ky0nq/VGA_security_homecam/UVM/OV7670_VGA/scenario2/rtl/MEM_CONTROLLER.sv

`timescale 1ns / 1ps

module MEM_CONTROLLER #(
    parameter int H_ACT      = 320,
    parameter int V_ACT      = 240,
    parameter int DATA_WIDTH = 16,
    parameter int ADDR_WIDTH = $clog2(H_ACT * V_ACT)
)(
    input  logic                    pclk,
    input  logic                    reset,
    input  logic                    href,
    input  logic                    v_sync,
    input  logic [7:0]              pdata,

    output logic                    we,
    output logic [ADDR_WIDTH-1:0]   addr,
    output logic [DATA_WIDTH-1:0]   data
);

    localparam int MAX_PIXELS = H_ACT * V_ACT;

    logic                    byte_sel;   
    logic [7:0]              hi_byte;   
    logic [ADDR_WIDTH-1:0]   pix_cnt;   

    always_ff @(posedge pclk or posedge reset) begin
        if (reset) begin
            byte_sel <= 1'b0;
            hi_byte  <= 8'd0;
            pix_cnt  <= '0;
            we       <= 1'b0;
            addr     <= '0;
            data     <= 16'd0;
        end else begin
            we <= 1'b0; 

            if (v_sync) begin
                byte_sel <= 1'b0;
                pix_cnt  <= '0;
            end else if (href) begin
                if (!byte_sel) begin
                    hi_byte  <= pdata;
                    byte_sel <= 1'b1;
                end else begin
                    byte_sel <= 1'b0;
                    if (pix_cnt < MAX_PIXELS) begin
                        we      <= 1'b1;
                        addr    <= pix_cnt;
                        data    <= {hi_byte, pdata};
                        pix_cnt <= pix_cnt + 1'b1;
                    end
                end
            end else begin
                byte_sel <= 1'b0;
            end
        end
    end
endmodule
