ky0nq/VGA_security_homecam/Board_2/gaussian_filter.sv

`timescale 1ns / 1ps

// =================================================================================
// Module: gauss_filter_pipe (Box Blur implementation)
// Description: Implements WIN x WIN spatial moving average filter (Box Blur).
// Architecture: 2-Stage Pipelined Summation
//   - Stage 1: Computes row-wise partial sums (WIN pixels per row)
//   - Stage 2: Combines row sums into a total sum and normalizes by WIN^2
// Latency: (WIN - 1) * IMG_WIDTH + WIN + 4 pclk cycles
// =================================================================================

module gauss_filter_pipe #(
    parameter int IMG_WIDTH = 800,  // Pixels per line (H_Whole_line)
    parameter int WIN       = 16   // Filter window size (WIN x WIN)
)(
    input  logic        clk,
    input  logic        rst_n,

    input  logic        i_h_sync,
    input  logic        i_v_sync,
    input  logic [11:0] i_rgb,      // {R[3:0], G[3:0], B[3:0]}

    output logic        o_h_sync,
    output logic        o_v_sync,
    output logic [11:0] o_rgb
);

    localparam int WEIGHT_SUM = WIN * WIN;
    localparam int LATENCY    = (WIN - 1) * IMG_WIDTH + WIN + 4;

    // Local Pixel Clock Generation
    logic pclk;
    pclk_gen U_PCLK_GEN (
        .clk   (clk),
        .rst_n (rst_n),
        .pclk  (pclk)
    );

    // Stage 0: Input Registering
    logic [11:0] rgb_in_r;
    always_ff @(posedge clk or negedge rst_n) begin
        if (!rst_n) rgb_in_r <= '0;
        else if (pclk) rgb_in_r <= i_rgb;
    end

    // Line Buffer Arrays (Row Streaming)
    logic [11:0] row_stream [0:WIN-1];
    assign row_stream[0] = rgb_in_r;

    genvar r;
    generate
        for (r = 1; r < WIN; r = r + 1) begin : gen_linebuf
            logic [11:0] line_buf [0:IMG_WIDTH-1];
            always_ff @(posedge clk or negedge rst_n) begin
                if (!rst_n) begin
                    for (int k = 0; k < IMG_WIDTH; k = k + 1) line_buf[k] <= '0;
                end else if (pclk) begin
                    for (int k = IMG_WIDTH-1; k > 0; k = k - 1)
                        line_buf[k] <= line_buf[k-1];
                    line_buf[0] <= row_stream[r-1];
                end
            end
            assign row_stream[r] = line_buf[IMG_WIDTH-1];
        end
    endgenerate

    // Column Shift Registers (Spatial Window Tap)
    logic [11:0] col_tap [0:WIN-1][0:WIN-1];

    genvar rr;
    generate
        for (rr = 0; rr < WIN; rr = rr + 1) begin : gen_colshift
            always_ff @(posedge clk or negedge rst_n) begin
                if (!rst_n) begin
                    for (int c = 0; c < WIN; c = c + 1) col_tap[rr][c] <= '0;
                end else if (pclk) begin
                    for (int c = WIN-1; c > 0; c = c - 1)
                        col_tap[rr][c] <= col_tap[rr][c-1];
                    col_tap[rr][0] <= row_stream[rr];
                end
            end
        end
    endgenerate

    // Stage 1: Row Partial Summation
    logic [15:0] row_sum_r_c [0:WIN-1];
    logic [15:0] row_sum_g_c [0:WIN-1];
    logic [15:0] row_sum_b_c [0:WIN-1];
    logic [15:0] row_sum_r   [0:WIN-1];
    logic [15:0] row_sum_g   [0:WIN-1];
    logic [15:0] row_sum_b   [0:WIN-1];

    genvar rs;
    generate
        for (rs = 0; rs < WIN; rs = rs + 1) begin : gen_row_sum
            always_comb begin
                row_sum_r_c[rs] = '0;
                row_sum_g_c[rs] = '0;
                row_sum_b_c[rs] = '0;
                for (int c = 0; c < WIN; c = c + 1) begin
                    row_sum_r_c[rs] = row_sum_r_c[rs] + col_tap[rs][c][11:8];
                    row_sum_g_c[rs] = row_sum_g_c[rs] + col_tap[rs][c][7:4];
                    row_sum_b_c[rs] = row_sum_b_c[rs] + col_tap[rs][c][3:0];
                end
            end
            always_ff @(posedge clk or negedge rst_n) begin
                if (!rst_n) begin
                    row_sum_r[rs] <= '0;
                    row_sum_g[rs] <= '0;
                    row_sum_b[rs] <= '0;
                end else if (pclk) begin
                    row_sum_r[rs] <= row_sum_r_c[rs];
                    row_sum_g[rs] <= row_sum_g_c[rs];
                    row_sum_b[rs] <= row_sum_b_c[rs];
                end
            end
        end
    endgenerate

    // Stage 2: Total Summation
    logic [23:0] sum_r_c, sum_g_c, sum_b_c;
    logic [23:0] sum_r,   sum_g,   sum_b;

    always_comb begin
        sum_r_c = '0; sum_g_c = '0; sum_b_c = '0;
        for (int rs2 = 0; rs2 < WIN; rs2 = rs2 + 1) begin
            sum_r_c = sum_r_c + row_sum_r[rs2];
            sum_g_c = sum_g_c + row_sum_g[rs2];
            sum_b_c = sum_b_c + row_sum_b[rs2];
        end
    end

    always_ff @(posedge clk or negedge rst_n) begin
        if (!rst_n) begin
            sum_r <= '0; sum_g <= '0; sum_b <= '0;
        end else if (pclk) begin
            sum_r <= sum_r_c;
            sum_g <= sum_g_c;
            sum_b <= sum_b_c;
        end
    end

    // Normalization & Output Stage
    function automatic logic [3:0] normalize(input logic [23:0] sum);
        logic [23:0] avg;
        avg = sum / WEIGHT_SUM;
        normalize = (avg > 24'd15) ? 4'hF : avg[3:0];
    endfunction

    logic [3:0] blur_r, blur_g, blur_b;
    assign blur_r = normalize(sum_r);
    assign blur_g = normalize(sum_g);
    assign blur_b = normalize(sum_b);

    always_ff @(posedge clk or negedge rst_n) begin
        if (!rst_n) begin
            o_rgb <= '0;
        end else if (pclk) begin
            o_rgb <= {blur_r, blur_g, blur_b};
        end
    end

    // Sync Signal Delay Pipeline (Matching Data Latency)
    logic [LATENCY-1:0] h_sync_d, v_sync_d;

    always_ff @(posedge clk or negedge rst_n) begin
        if (!rst_n) begin
            h_sync_d <= {LATENCY{1'b1}};
            v_sync_d <= {LATENCY{1'b1}};
        end else if (pclk) begin
            h_sync_d <= {h_sync_d[LATENCY-2:0], i_h_sync};
            v_sync_d <= {v_sync_d[LATENCY-2:0], i_v_sync};
        end
    end

    assign o_h_sync = h_sync_d[LATENCY-1];
    assign o_v_sync = v_sync_d[LATENCY-1];

endmodule
