ky0nq/VGA_security_homecam/UVM/Top/AUTH_LOCKOUT/TB/components/uvm_agent.sv

// Per-board agent containing the sequencer, driver, and monitor.
class Agent extends uvm_agent;
    `uvm_component_utils(Agent)
    Sequencer sqr;
    Driver    drv;
    Monitor   mon;
    function new(string name = "Agent", uvm_component parent = null);
        super.new(name, parent);
    endfunction
    function void build_phase(uvm_phase phase);
        super.build_phase(phase);
        sqr = Sequencer::type_id::create("sqr", this);
        drv = Driver::type_id::create("drv", this);
        mon = Monitor::type_id::create("mon", this);
    endfunction
    function void connect_phase(uvm_phase phase);
        super.connect_phase(phase);
        drv.seq_item_port.connect(sqr.seq_item_export);
    endfunction
endclass
