ky0nq/VGA_security_homecam/UVM/Top/AUTH_LOCKOUT/TB/components/uvm_sequencer.sv

// Pass sequence transactions to the driver.
class Sequencer extends uvm_sequencer #(transaction);
    `uvm_component_utils(Sequencer)
    function new(string name = "Sequencer", uvm_component parent = null);
        super.new(name, parent);
    endfunction
endclass
