ky0nq/VGA_security_homecam/UVM/OV7670_VGA/scenario2/tb/vga/vga_pkg.sv

`ifndef VGA_PKG_SV
`define VGA_PKG_SV
//======================================================================
//  vga_pkg
//======================================================================
package vga_pkg;
  `include "uvm_macros.svh"
  import uvm_pkg::*;
  `include "defs.svh"

  `include "vga_frame_txn.sv"
  `include "vga_monitor.sv"
  `include "vga_agent.sv"
endpackage
`endif
