ky0nq/VGA_security_homecam/UVM/OV7670_VGA/scenario2/tb/vga/vga_frame_txn.sv

`ifndef VGA_FRAME_TXN_SV
`define VGA_FRAME_TXN_SV
//======================================================================
//  vga_frame_txn : represents one observed VGA frame (active region)
//======================================================================
class vga_frame_txn extends uvm_sequence_item;
  int       HD = `VGA_HACT;
  int       VD = `VGA_VACT;
  bit [3:0] r [];
  bit [3:0] g [];
  bit [3:0] b [];
  bit       seen [];

  `uvm_object_utils(vga_frame_txn)

  function new(string name="vga_frame_txn");
    super.new(name);
    r    = new[HD*VD];
    g    = new[HD*VD];
    b    = new[HD*VD];
    seen = new[HD*VD];
  endfunction
endclass
`endif
