ky0nq/VGA_security_homecam/UVM/OV7670_VGA/scenario2/tb/sccb/sccb_txn.sv

`ifndef SCCB_TXN_SV
`define SCCB_TXN_SV
//======================================================================
//  sccb_txn : represents one 3-byte SCCB write transaction
//======================================================================
class sccb_txn extends uvm_sequence_item;
  bit [7:0] id;      // 0x42
  bit [7:0] addr;    // Register address
  bit [7:0] data;    // Register value

  `uvm_object_utils(sccb_txn)

  function new(string name="sccb_txn");
    super.new(name);
  endfunction

  function string convert2string();
    return $sformatf("SCCB id=%02h addr=%02h data=%02h", id, addr, data);
  endfunction
endclass
`endif
