ky0nq/VGA_security_homecam/UVM/OV7670_VGA/scenario2/tb/sccb/sccb_pkg.sv

`ifndef SCCB_PKG_SV
`define SCCB_PKG_SV
//======================================================================
//  sccb_pkg 
//======================================================================
package sccb_pkg;
  `include "uvm_macros.svh"
  import uvm_pkg::*;

  `include "sccb_txn.sv"
  `include "sccb_monitor.sv"
  `include "sccb_agent.sv"
endpackage
`endif
