ky0nq/VGA_security_homecam/UVM/OV7670_VGA/scenario2/tb/cam/cam_pkg.sv

`ifndef CAM_PKG_SV
`define CAM_PKG_SV
//======================================================================
//  cam_pkg
//======================================================================
package cam_pkg;
  `include "uvm_macros.svh"
  import uvm_pkg::*;
  `include "defs.svh"

  `include "cam_cfg.sv"
  `include "cam_frame_item.sv"
  `include "cam_sequencer.sv"
  `include "cam_driver.sv"
  `include "cam_monitor.sv"
  `include "cam_agent.sv"
  `include "cam_seq_lib.sv"
endpackage
`endif
