ky0nq/VGA_security_homecam/UVM/OV7670_VGA/scenario2/tb/cam/cam_sequencer.sv

`ifndef CAM_SEQUENCER_SV
`define CAM_SEQUENCER_SV
//======================================================================
//  cam_sequencer
//======================================================================
typedef uvm_sequencer #(cam_frame_item) cam_sequencer;
`endif
