ky0nq/VGA_security_homecam/UVM/OV7670_VGA/scenario1/tb/cam_vga_agent.sv

class cam_vga_agent extends uvm_agent;
    `uvm_component_utils(cam_vga_agent)
    uvm_sequencer #(cam_vga_seq_item) sqr;
    cam_vga_driver drv;
    cam_vga_monitor mon;
    function new(string name,uvm_component parent); super.new(name,parent); endfunction
    function void build_phase(uvm_phase phase);
        super.build_phase(phase);
        sqr=uvm_sequencer#(cam_vga_seq_item)::type_id::create("sqr",this);
        drv=cam_vga_driver::type_id::create("drv",this);
        mon=cam_vga_monitor::type_id::create("mon",this);
    endfunction
    function void connect_phase(uvm_phase phase);
        drv.seq_item_port.connect(sqr.seq_item_export);
    endfunction
endclass
