ky0nq/VGA_security_homecam/Board_2/gamma_filter.sv

`timescale 1ns / 1ps

// =================================================================================
// Module: gamma_filter_pipe
// Description: Pipelined Gamma Correction filter using a 16-entry Look-Up Table (LUT).
//
// Formula: out = 15 * (in / 15)^gamma  (RGB444, 4-bit per color channel)
// Modes:
//   - gamma_level = 0: Bright    (gamma = 0.7, LUT_G07)
//   - gamma_level = 1: Brighter  (gamma = 0.3, LUT_G03)
// Latency: 1 Clock Cycle
// =================================================================================

module gamma_filter_pipe (
    input  logic        clk,
    input  logic        rst_n,

    input  logic        gamma_en,
    input  logic        gamma_level,  // 0 = Bright (G0.7), 1 = Brighter (G0.3)

    input  logic        i_h_sync,
    input  logic        i_v_sync,
    input  logic [11:0] i_rgb,

    output logic        o_h_sync,
    output logic        o_v_sync,
    output logic [11:0] o_rgb
);

    // 16-Entry Gamma Lookup Tables
    localparam logic [3:0] LUT_G03[0:15] = '{
        4'd0, 4'd7, 4'd8, 4'd9, 4'd10, 4'd11, 4'd11, 4'd12,
        4'd12, 4'd13, 4'd13, 4'd14, 4'd14, 4'd14, 4'd15, 4'd15
    };

    localparam logic [3:0] LUT_G07[0:15] = '{
        4'd0, 4'd2, 4'd4, 4'd5, 4'd6, 4'd7, 4'd8, 4'd9,
        4'd10, 4'd10, 4'd11, 4'd12, 4'd13, 4'd14, 4'd14, 4'd15
    };

    // Internal RGB Channel Signals
    logic [3:0] r_in, g_in, b_in;
    logic [3:0] r_gamma, g_gamma, b_gamma;

    // Channel De-muxing
    assign r_in = i_rgb[11:8];
    assign g_in = i_rgb[7:4];
    assign b_in = i_rgb[3:0];

    // Gamma LUT Mapping (Combinational)
    always_comb begin
        if (gamma_level) begin
            r_gamma = LUT_G03[r_in];
            g_gamma = LUT_G03[g_in];
            b_gamma = LUT_G03[b_in];
        end else begin
            r_gamma = LUT_G07[r_in];
            g_gamma = LUT_G07[g_in];
            b_gamma = LUT_G07[b_in];
        end
    end

    // Pipeline Stage 1: RGB Processing Output
    always_ff @(posedge clk or negedge rst_n) begin
        if (!rst_n) begin
            o_rgb <= 12'd0;
        end else begin
            o_rgb <= gamma_en ? {r_gamma, g_gamma, b_gamma} : i_rgb;
        end
    end

    // Pipeline Stage 1: Sync Signals Delay Matching
    always_ff @(posedge clk or negedge rst_n) begin
        if (!rst_n) begin
            o_h_sync <= 1'b1;
            o_v_sync <= 1'b1;
        end else begin
            o_h_sync <= i_h_sync;
            o_v_sync <= i_v_sync;
        end
    end

endmodule
