ky0nq/VGA_security_homecam/Board_2/blue_filter.sv

`timescale 1ns / 1ps

// =================================================================================
// Module: blue_filter_pipe
// Description: Applies a blue color filter (cool tone effect) to RGB444 video.
// Latency: 2 clock cycles
// =================================================================================

module blue_filter_pipe (
    input  logic        clk,
    input  logic        rst_n,
    input  logic        blue_en,
    input  logic        i_h_sync,
    input  logic        i_v_sync,
    input  logic [11:0] i_rgb,

    output logic        o_h_sync,
    output logic        o_v_sync,
    output logic [11:0] o_rgb
);
    localparam LATENCY = 2;

    // Stage 1: Calculate luminance weights
    logic [11:0] s1_r, s1_g, s1_b, s1_rgb;

    always_ff @(posedge clk or negedge rst_n) begin
        if (!rst_n) begin
            s1_r   <= 0;
            s1_g   <= 0;
            s1_b   <= 0;
            s1_rgb <= 0;
        end else begin
            s1_r   <= 8'd77  * i_rgb[11:8];  // R weight (~0.3)
            s1_g   <= 8'd150 * i_rgb[7:4];   // G weight (~0.58)
            s1_b   <= 8'd29  * i_rgb[3:0];   // B weight (~0.11)
            s1_rgb <= i_rgb;
        end
    end

    // Stage 2: Convert to grayscale and apply blue tint
    logic [11:0] y_sum;
    logic [ 3:0] gray;
    logic [ 3:0] blue_r, blue_g, blue_b;

    assign y_sum = s1_r + s1_g + s1_b;
    assign gray  = y_sum[11:8];

    assign blue_r = gray >> 2;             // 25% Red
    assign blue_g = gray - (gray >> 1);    // 50% Green
    assign blue_b = gray;                  // 100% Blue

    always_ff @(posedge clk or negedge rst_n) begin
        if (!rst_n) begin
            o_rgb <= 0;
        end else begin
            o_rgb <= blue_en ? {blue_r, blue_g, blue_b} : s1_rgb;
        end
    end

    // Sync signal delay matching (2 cycles)
    logic [LATENCY-1:0] h_sync_d, v_sync_d;

    always_ff @(posedge clk or negedge rst_n) begin
        if (!rst_n) begin
            h_sync_d <= {LATENCY{1'b1}};
            v_sync_d <= {LATENCY{1'b1}};
        end else begin
            h_sync_d <= {h_sync_d[LATENCY-2:0], i_h_sync};
            v_sync_d <= {v_sync_d[LATENCY-2:0], i_v_sync};
        end
    end

    assign o_h_sync = h_sync_d[LATENCY-1];
    assign o_v_sync = v_sync_d[LATENCY-1];

endmodule
