ky0nq/VGA_security_homecam/UVM/OV7670_VGA/scenario1/tb/cam_vga_test.sv

class cam_vga_sccb_reset_sequence extends uvm_sequence #(cam_vga_seq_item);
    `uvm_object_utils(cam_vga_sccb_reset_sequence)
    bit target_setup=0;
    int target_state=-1, target_step=-1;
    bit target_observed=0;
    function new(string name="sccb_reset_sequence"); super.new(name); endfunction
    task body();
        cam_vga_seq_item req;
        req=cam_vga_seq_item::type_id::create("reset_request");
        start_item(req);
        req.command=CMD_SCCB_RESET_AT;
        req.sccb_target_setup=target_setup;
        req.sccb_target_state=target_state;
        req.sccb_target_step=target_step;
        finish_item(req);
        target_observed=req.sccb_target_observed;
    endtask
endclass

class cam_vga_test extends uvm_test;
    `uvm_component_utils(cam_vga_test)
    cam_vga_env env;
    virtual cam_vga_if vif;
    string mode="camera_random";
    int num_frames=10;
    bit run_completed=0;
    function new(string name,uvm_component parent); super.new(name,parent); endfunction
    function void build_phase(uvm_phase phase);
        super.build_phase(phase);
        if(!uvm_config_db#(virtual cam_vga_if)::get(this,"","vif",vif))
            `uvm_fatal("VIF","cam_vga_test needs vif")
        void'($value$plusargs("NUM_FRAMES=%d",num_frames));
        if(num_frames<1) `uvm_fatal("NUM_FRAMES","NUM_FRAMES must be positive")
        env=cam_vga_env::type_id::create("env",this);
    endfunction
    task command(command_e cmd);
        cam_vga_command_sequence seq;
        seq=cam_vga_command_sequence::type_id::create("command_seq");
        seq.command=cmd; seq.start(env.agt.sqr);
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
