ky0nq/VGA_security_homecam/(commit log)

2026-09-01 Create board1_system
2026-09-01 Create uart_tx
2026-09-01 Add minimal 8N1 UART receiver module
2026-09-01 b/d에 맞게 en 신호 없앰
2026-09-01 blue filter
2026-09-01 ex.sv 삭제
2026-09-01 ex 만들기
2026-09-07 Add Board_1 SV files
2026-09-07 Update BOARD_1 SV files
2026-09-07 BOARD_2 폴더에 파일 업로드
2026-09-07 Refactor Frame_Buffer module and clean comments
    Removed comments in Korean and updated initial memory setup.
2026-09-07 Add cam_agent class for camera agent functionality
2026-09-07 Add base_test class for solid green frame test
2026-09-07 Fix comments and formatting in cam_driver.sv
    [cam_driver.sv]
2026-09-07 Update comments and error messages in sccb_monitor.sv
    [sccb_monitor.sv]
